besturk/claude-todo/makerworld-thermoform/healy-cerceve/healy-c-erkek.stl

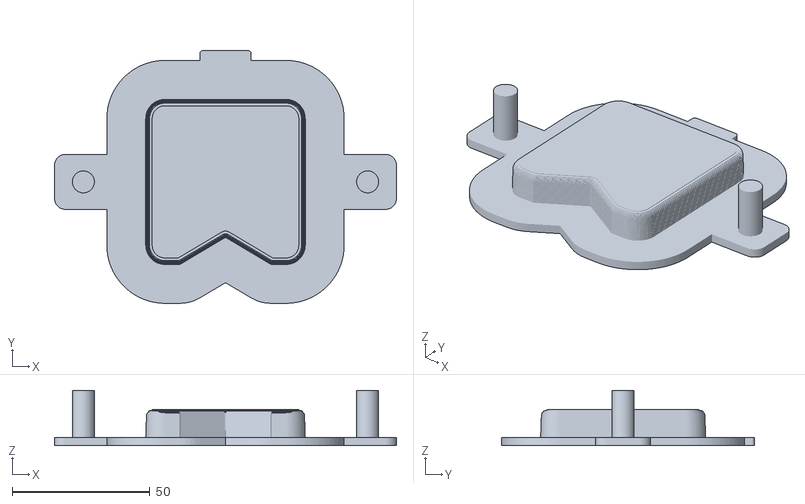
[picture p1: CAD file, 2026-10-13]
makerworld-thermoform/healy-cerceve/healy-c-erkek.stl
124.3 x 91.8 x 20.0
