besturk/claude-todo/makerworld-thermoform/healy-formify/TF-Healy-F-kalip-PETG.3mf

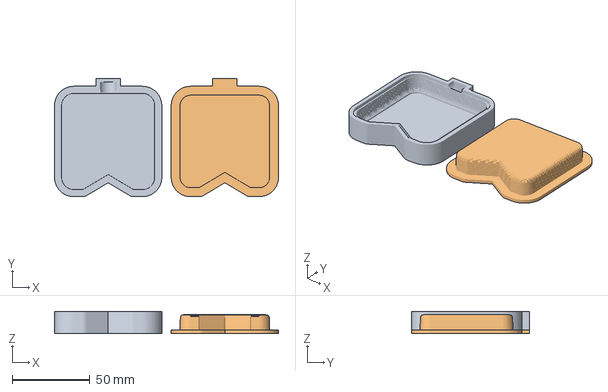
[picture p2: CAD file, 2026-10-12]
makerworld-thermoform/healy-formify/TF-Healy-F-kalip-PETG.3mf
144.0 x 76.1 x 14.2 mm
disi-kalip
erkek-kalip
