besturk/claude-todo/makerworld-thermoform/healy-hk/TF-Healy-HK-levha-PLA.3mf

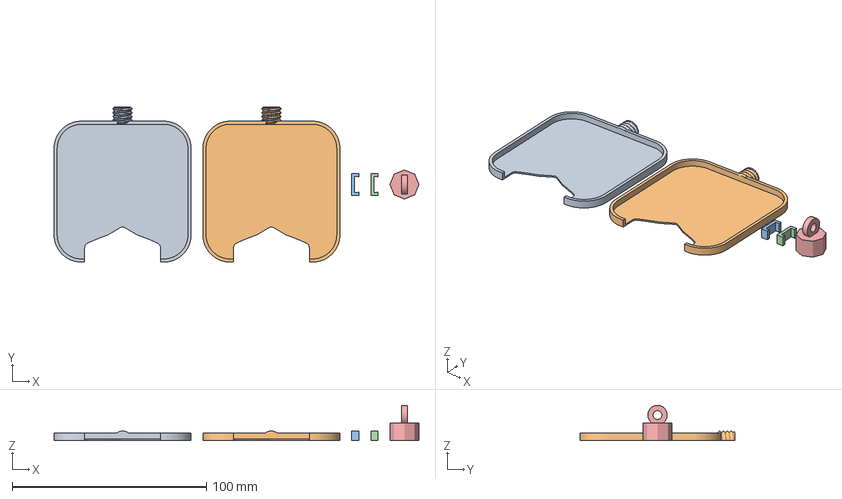
[picture p3: CAD file, 2026-10-14]
makerworld-thermoform/healy-hk/TF-Healy-HK-levha-PLA.3mf
188.0 x 80.0 x 18.2 mm
levha-1
levha-2
kiskac-1
kiskac-2
askili-somun
