besturk/claude-todo/makerworld-thermoform/healy-kalip/healy-levha.stl

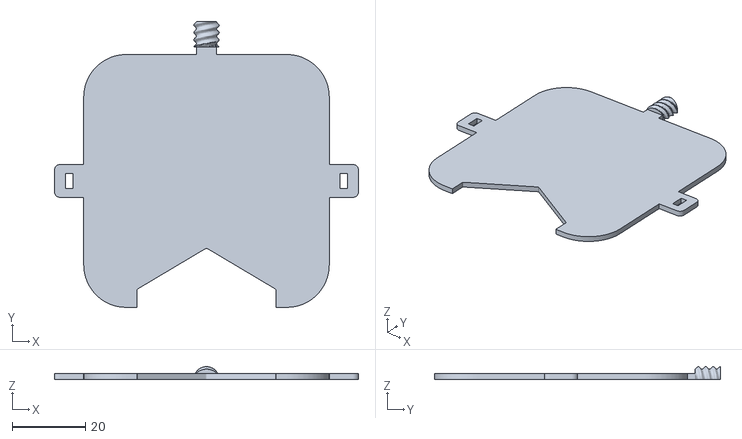
[picture p4: CAD file, 2026-10-12]
makerworld-thermoform/healy-kalip/healy-levha.stl
83.2 x 78.2 x 3.50
