besturk/claude-todo/makerworld-thermoform/kare-50/kare50-zipka.stl

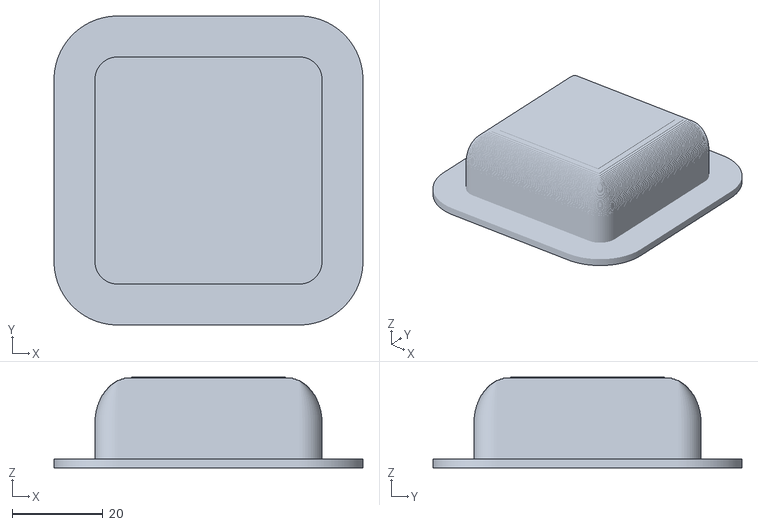
[picture p5: CAD file, 2026-10-11]
makerworld-thermoform/kare-50/kare50-zipka.stl
68.0 x 68.0 x 20.0
