besturk/claude-todo/makerworld-thermoform/healy-cerceve/healy-c-levha_duz.stl

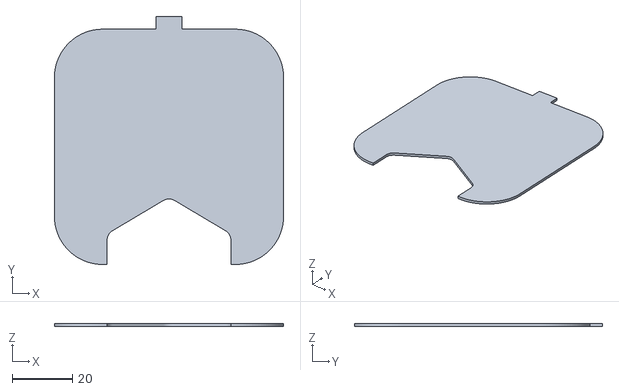
[picture p6: CAD file, 2026-10-13]
makerworld-thermoform/healy-cerceve/healy-c-levha_duz.stl
76.0 x 82.2 x 1.00
