besturk/claude-todo/makerworld-thermoform/healy-formify/TF-Healy-F-levhalar-PLA.3mf

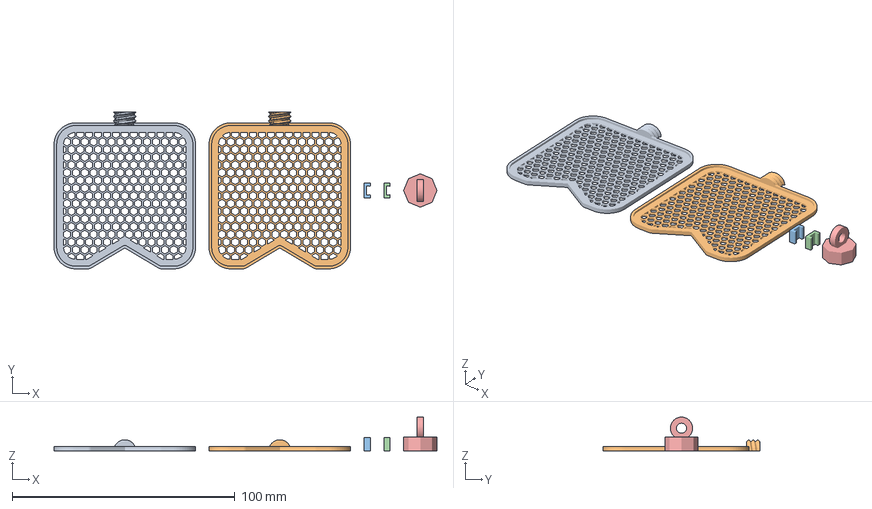
[picture p7: CAD file, 2026-10-12]
makerworld-thermoform/healy-formify/TF-Healy-F-levhalar-PLA.3mf
172.0 x 70.4 x 15.2 mm
levha-1
levha-2
kiskac-1
kiskac-2
somun
