besturk/claude-todo/makerworld-thermoform/healy-hk/healy-hk-disi.stl

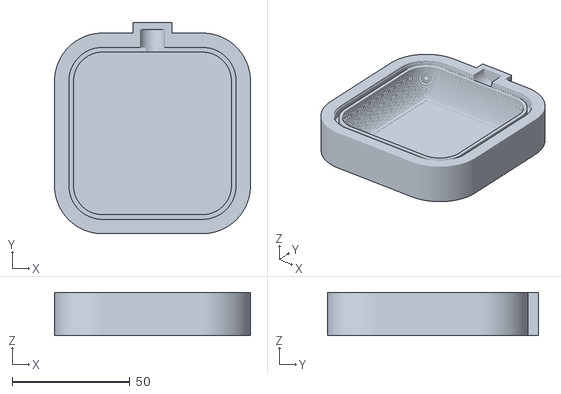
[picture p8: CAD file, 2026-10-14]
makerworld-thermoform/healy-hk/healy-hk-disi.stl
83.2 x 89.8 x 18.3
