besturk/claude-todo/makerworld-thermoform/healy-kalip/healy-zipka.stl

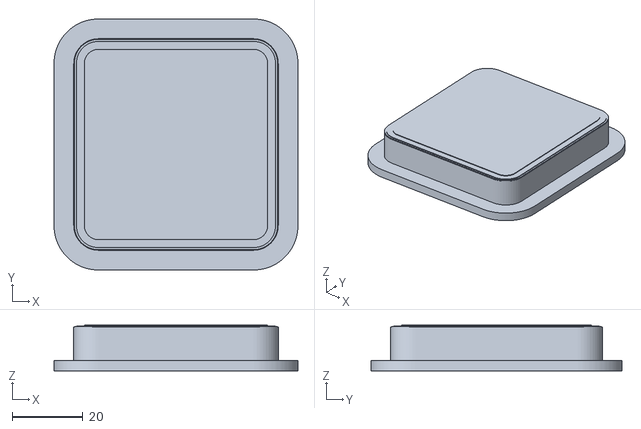
[picture p9: CAD file, 2026-10-12]
makerworld-thermoform/healy-kalip/healy-zipka.stl
69.2 x 71.2 x 13.0
