besturk/claude-todo/makerworld-thermoform/kare-50/kare50-kalip.stl

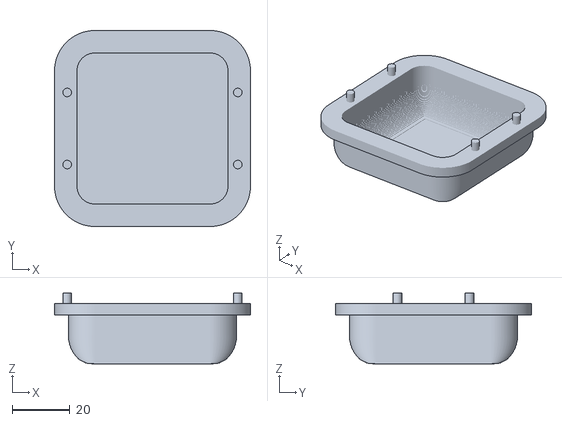
[picture p10: CAD file, 2026-10-11]
makerworld-thermoform/kare-50/kare50-kalip.stl
68.0 x 68.0 x 24.6
