besturk/claude-todo/makerworld-thermoform/healy-cerceve/healy-c-direk_destek.stl

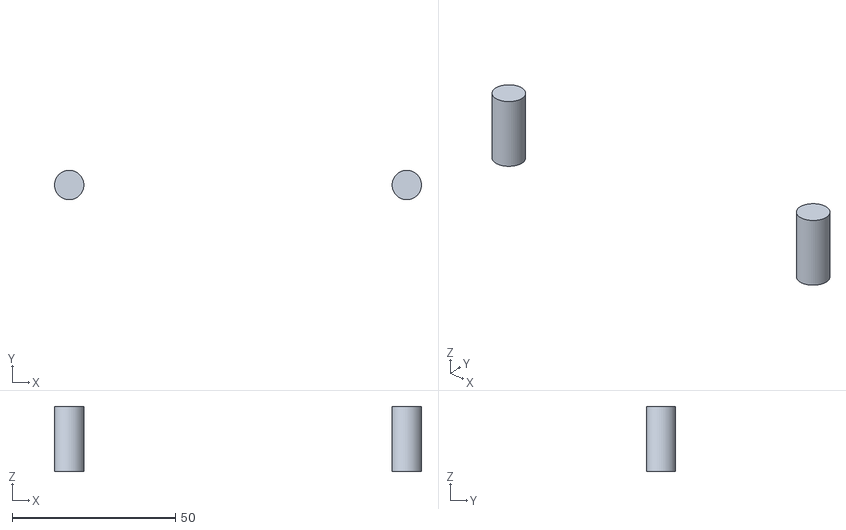
[picture p11: CAD file, 2026-10-13]
makerworld-thermoform/healy-cerceve/healy-c-direk_destek.stl
112.3 x 9.00 x 20.0
