besturk/claude-todo/makerworld-thermoform/healy-formify/healy-f-levha.stl

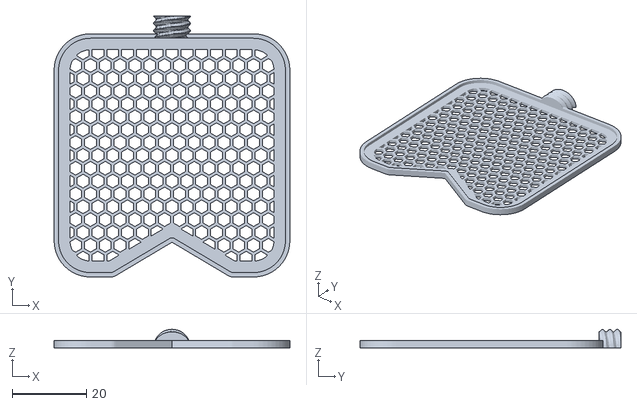
[picture p12: CAD file, 2026-10-12]
makerworld-thermoform/healy-formify/healy-f-levha.stl
63.6 x 70.4 x 5.00
