besturk/claude-todo/makerworld-thermoform/healy-hk/healy-hk-levha_govde.stl

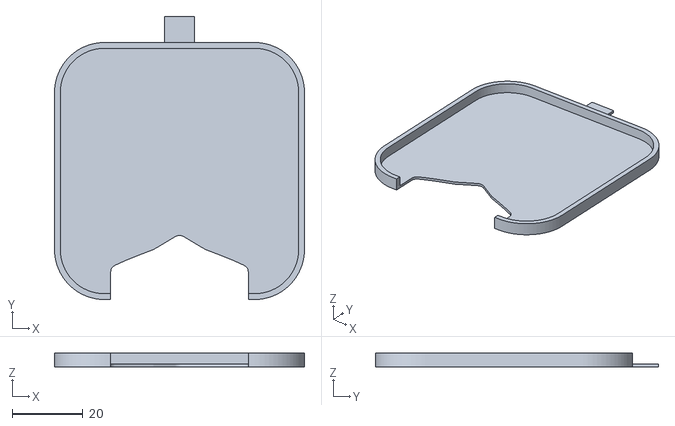
[picture p13: CAD file, 2026-10-14]
makerworld-thermoform/healy-hk/healy-hk-levha_govde.stl
70.7 x 80.0 x 4.00
