besturk/claude-todo/makerworld-thermoform/healy-kalip/healy-kalip.stl

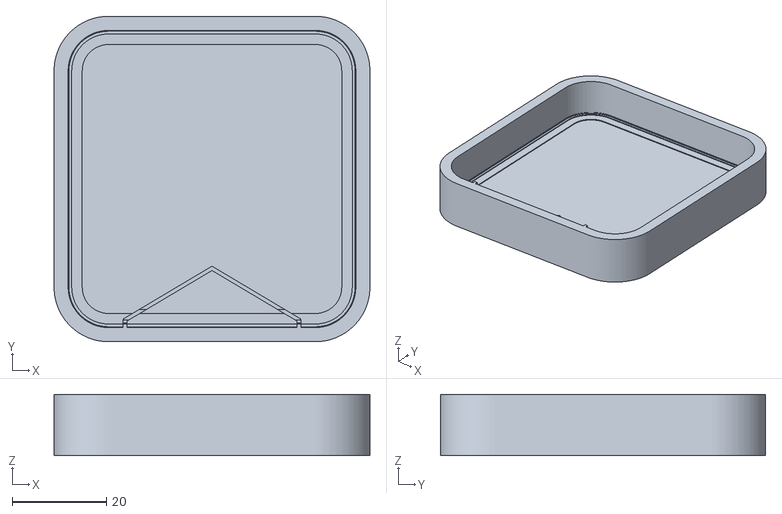
[picture p14: CAD file, 2026-10-12]
makerworld-thermoform/healy-kalip/healy-kalip.stl
67.2 x 69.2 x 13.0
