besturk/claude-todo/makerworld-thermoform/healy-cerceve/TF-Healy-cerceve-kalip-PETG.3mf

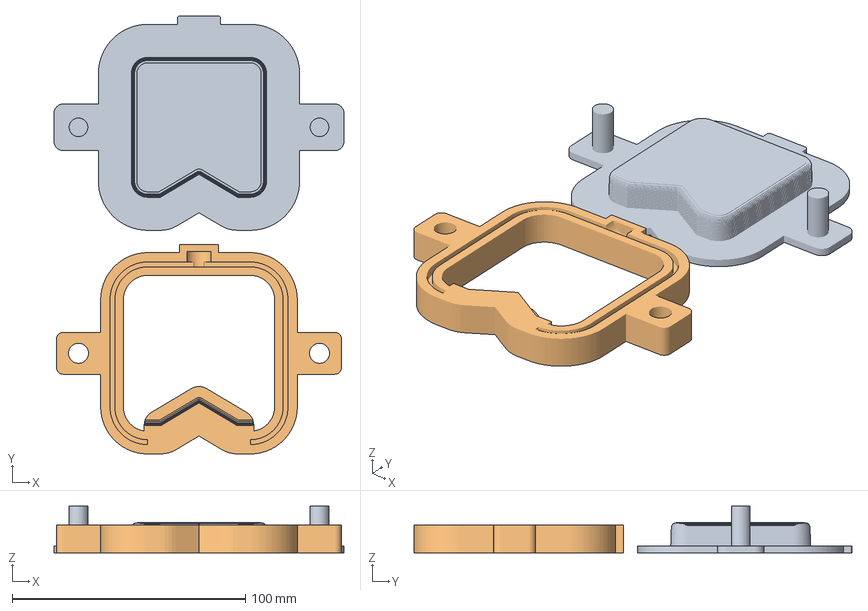
[picture p15: CAD file, 2026-10-13]
makerworld-thermoform/healy-cerceve/TF-Healy-cerceve-kalip-PETG.3mf
124.3 x 187.7 x 20.0 mm
erkek-kalip
cerceve
