besturk/claude-todo/makerworld-thermoform/healy-formify/healy-f-disi.stl

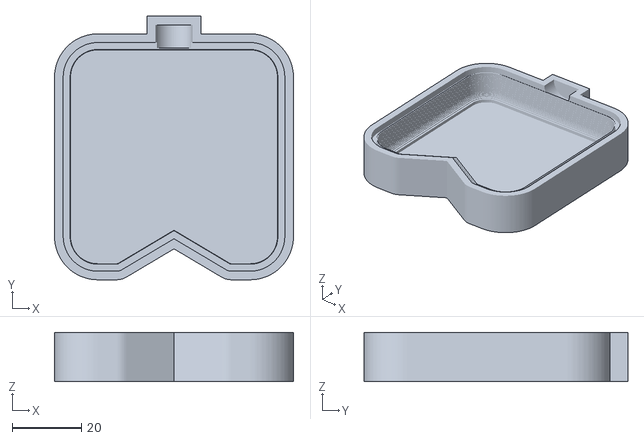
[picture p16: CAD file, 2026-10-12]
makerworld-thermoform/healy-formify/healy-f-disi.stl
69.0 x 76.1 x 14.2
