besturk/claude-todo/makerworld-thermoform/healy-hk/healy-hk-erkek.stl

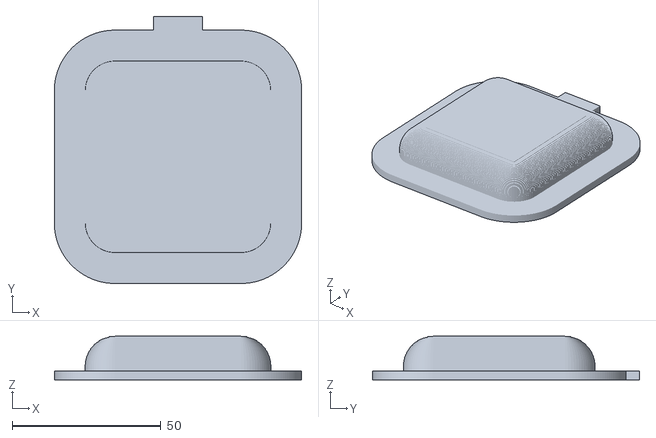
[picture p17: CAD file, 2026-10-14]
makerworld-thermoform/healy-hk/healy-hk-erkek.stl
83.2 x 89.8 x 14.7
