besturk/claude-todo/makerworld-thermoform/healy-kalip/TF-Healy-levhalar-PLA.3mf

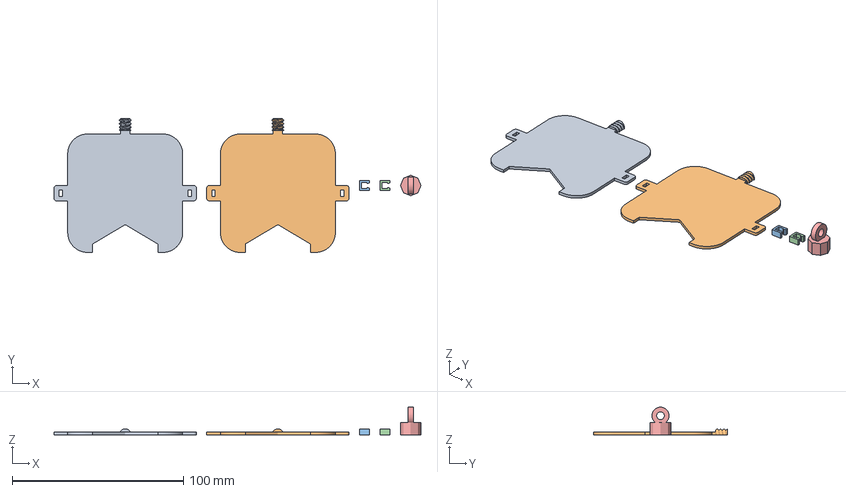
[picture p18: CAD file, 2026-10-12]
makerworld-thermoform/healy-kalip/TF-Healy-levhalar-PLA.3mf
214.4 x 78.2 x 16.2 mm
levha-1
levha-2
c-kiskac-1
c-kiskac-2
askili-somun
