besturk/claude-todo/makerworld-thermoform/healy-cerceve/healy-c-cerceve_baski.stl

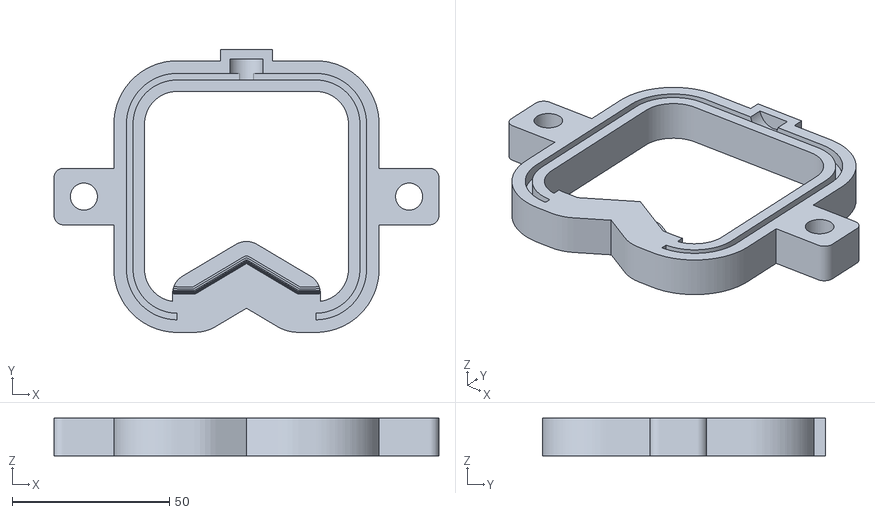
[picture p19: CAD file, 2026-10-13]
makerworld-thermoform/healy-cerceve/healy-c-cerceve_baski.stl
122.3 x 89.8 x 12.0
