besturk/claude-todo/makerworld-thermoform/healy-formify/healy-f-erkek.stl

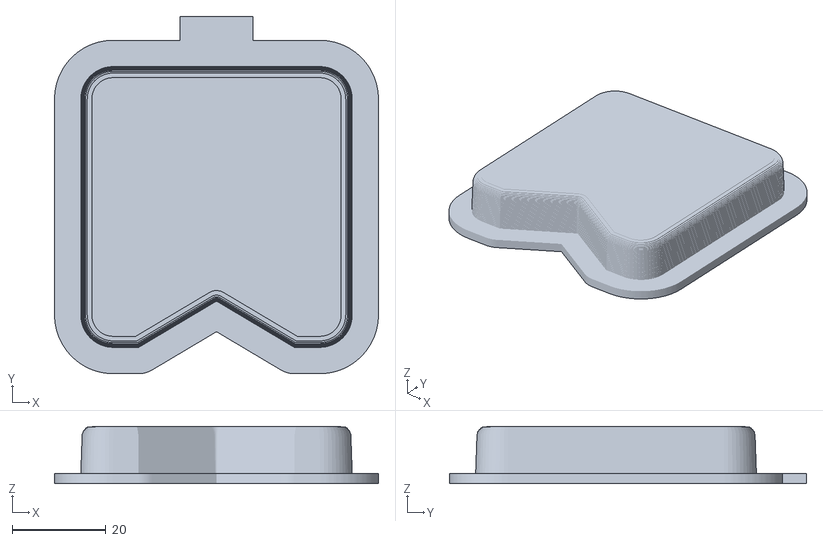
[picture p20: CAD file, 2026-10-12]
makerworld-thermoform/healy-formify/healy-f-erkek.stl
69.0 x 76.1 x 12.2
