besturk/claude-todo/makerworld-thermoform/healy-hk/healy-hk-kiskac.stl

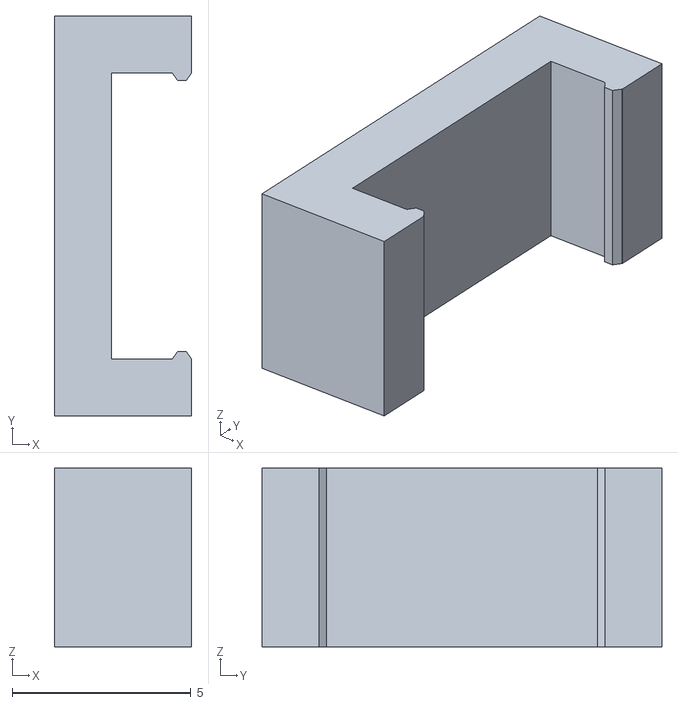
[picture p21: CAD file, 2026-10-14]
makerworld-thermoform/healy-hk/healy-hk-kiskac.stl
3.85 x 11.2 x 5.00
