besturk/claude-todo/makerworld-thermoform/healy-kalip/TF-Healy-kalip-PETG.3mf

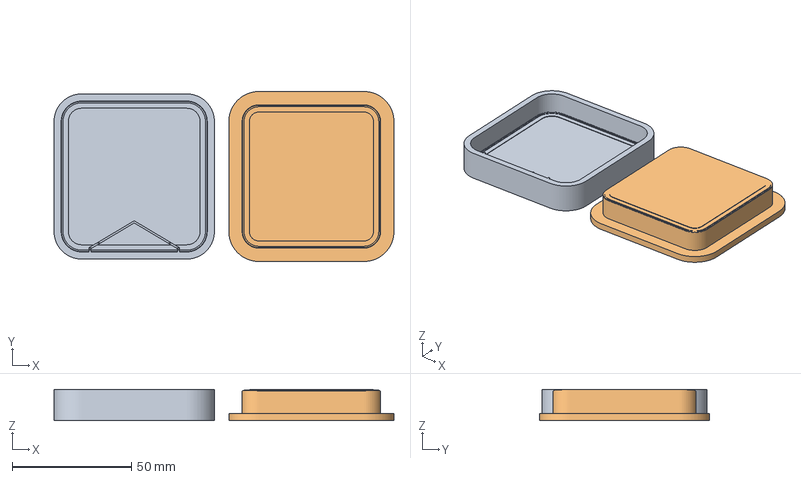
[picture p22: CAD file, 2026-10-12]
makerworld-thermoform/healy-kalip/TF-Healy-kalip-PETG.3mf
142.4 x 71.2 x 13.0 mm
healy-kalip-disi
healy-zipka-erkek
