besturk/claude-todo/makerworld-thermoform/healy-cerceve/healy-c-bant.stl

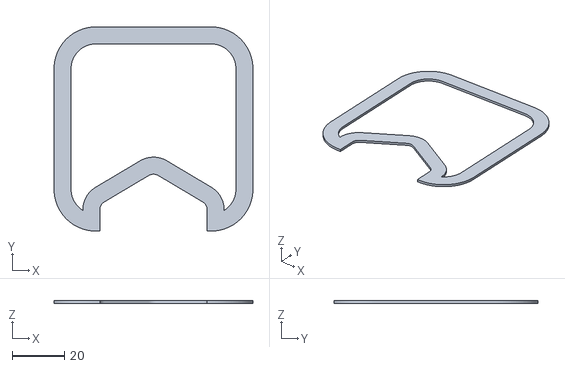
[picture p23: CAD file, 2026-10-13]
makerworld-thermoform/healy-cerceve/healy-c-bant.stl
76.0 x 78.0 x 1.00
