besturk/claude-todo/makerworld-thermoform/healy-formify/healy-f-somun.stl

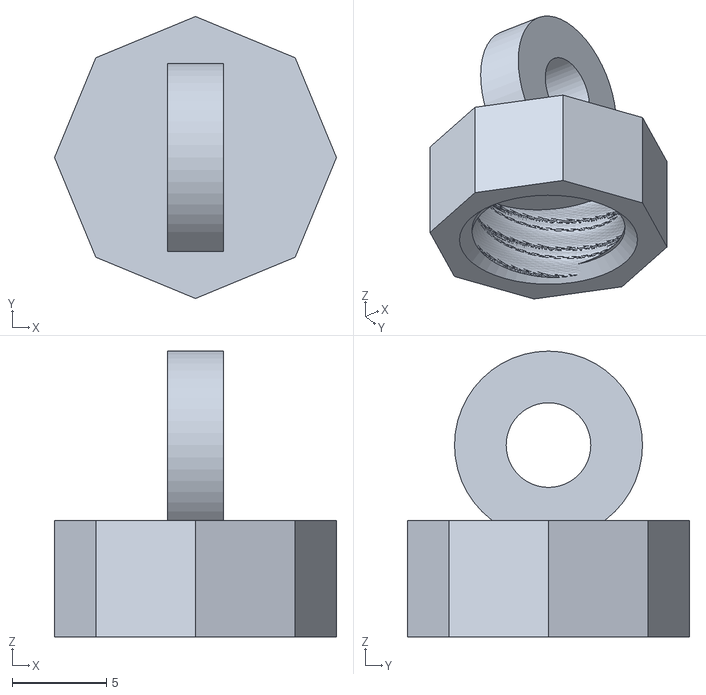
[picture p24: CAD file, 2026-10-12]
makerworld-thermoform/healy-formify/healy-f-somun.stl
15.0 x 15.0 x 15.2
