besturk/claude-todo/makerworld-thermoform/healy-hk/healy-hk-vida.stl

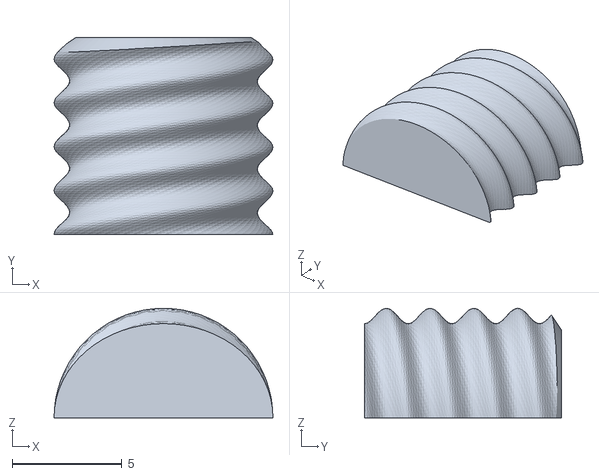
[picture p25: CAD file, 2026-10-14]
makerworld-thermoform/healy-hk/healy-hk-vida.stl
10.0 x 9.00 x 5.00
