besturk/claude-todo/makerworld-thermoform/healy-kalip/healy-levhalar-PLA.3mf

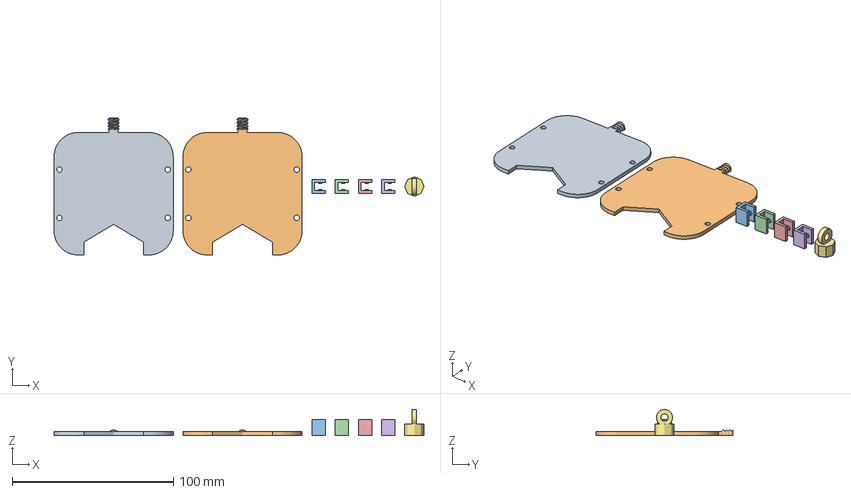
[picture p26: CAD file, 2026-10-11]
makerworld-thermoform/healy-kalip/healy-levhalar-PLA.3mf
229.6 x 85.0 x 16.2 mm
levha-1
levha-2
c-kiskac-1
c-kiskac-2
c-kiskac-3
c-kiskac-4
askili-somun
