besturk/claude-todo/makerworld-thermoform/healy-cerceve/healy-c-levha.stl

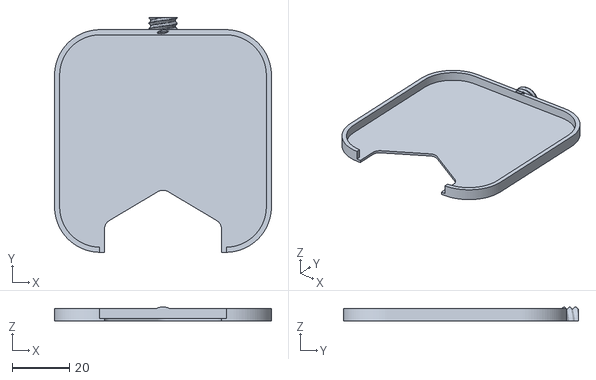
[picture p27: CAD file, 2026-10-13]
makerworld-thermoform/healy-cerceve/healy-c-levha.stl
76.0 x 82.2 x 5.00
