besturk/claude-todo/makerworld-thermoform/healy-formify/healy-f-kiskac.stl

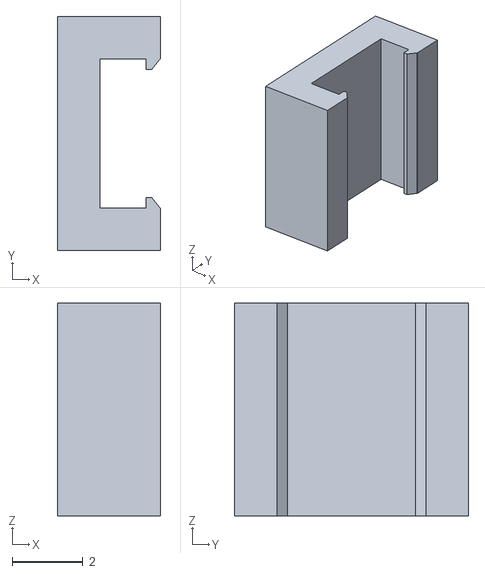
[picture p28: CAD file, 2026-10-12]
makerworld-thermoform/healy-formify/healy-f-kiskac.stl
2.90 x 6.60 x 6.00
