besturk/claude-todo/makerworld-thermoform/healy-hk/healy-hk-somun.stl

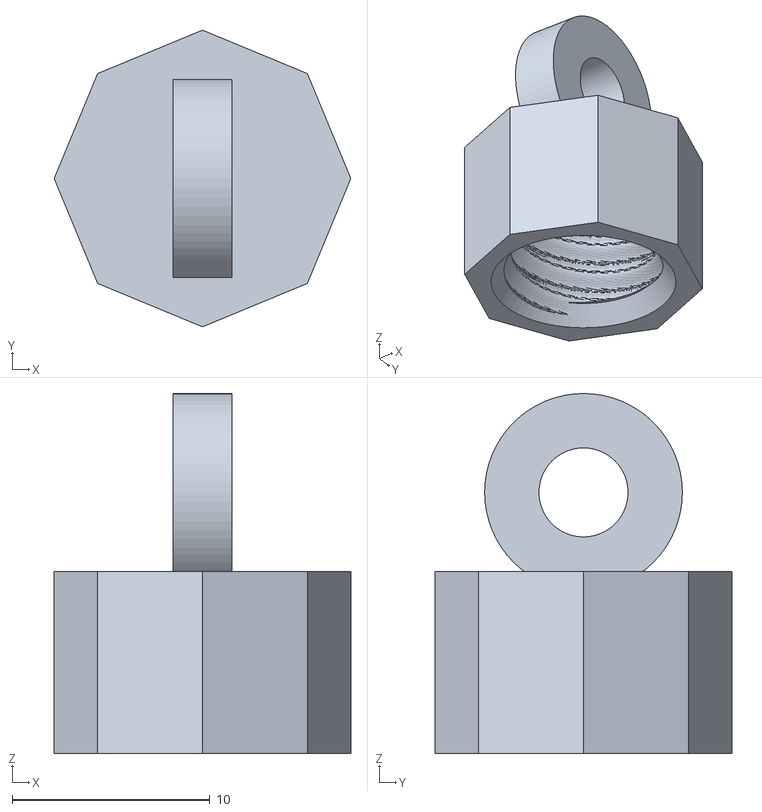
[picture p29: CAD file, 2026-10-14]
makerworld-thermoform/healy-hk/healy-hk-somun.stl
15.0 x 15.0 x 18.2
