besturk/claude-todo/makerworld-thermoform/healy-kalip/healy-kiskac-somun.stl

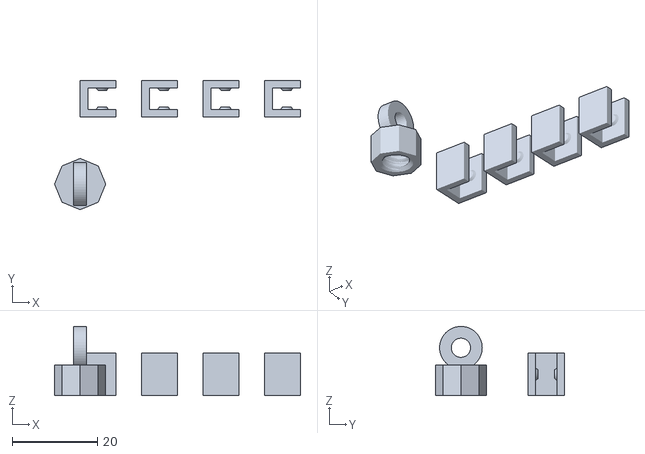
[picture p30: CAD file, 2026-10-11]
makerworld-thermoform/healy-kalip/healy-kiskac-somun.stl
57.6 x 30.3 x 16.2
