besturk/claude-todo/makerworld-thermoform/healy-cerceve/TF-Healy-cerceve-levha-PLA.3mf

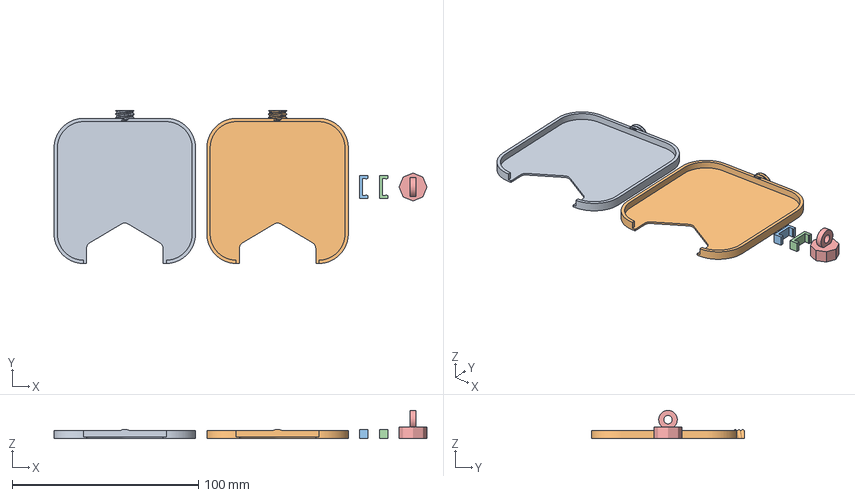
[picture p31: CAD file, 2026-10-13]
makerworld-thermoform/healy-cerceve/TF-Healy-cerceve-levha-PLA.3mf
200.2 x 82.2 x 15.2 mm
levha-1
levha-2
yan-kiskac-1
yan-kiskac-2
askili-somun
