besturk/claude-todo/makerworld-thermoform/healy-hk/TF-Healy-HK-kalip-PETG.3mf

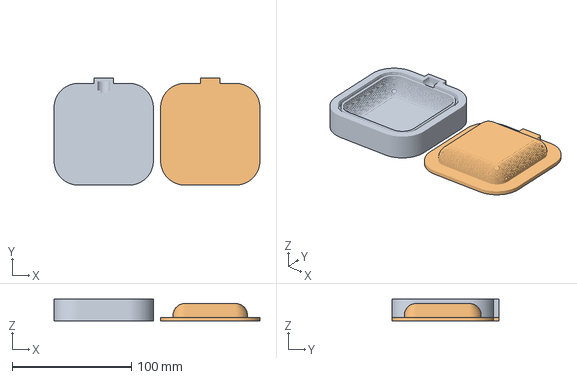
[picture p32: CAD file, 2026-10-14]
makerworld-thermoform/healy-hk/TF-Healy-HK-kalip-PETG.3mf
172.4 x 89.8 x 18.3 mm
disi-kalip
erkek-kalip
