besturk/claude-todo/makerworld-thermoform/healy-cerceve/healy-c-kaburga.stl

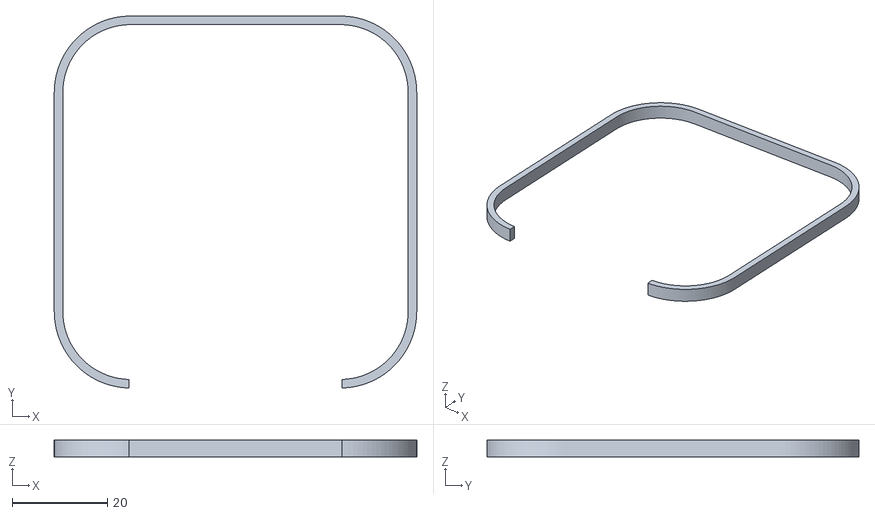
[picture p33: CAD file, 2026-10-13]
makerworld-thermoform/healy-cerceve/healy-c-kaburga.stl
76.0 x 78.0 x 3.51
