besturk/claude-todo/makerworld-thermoform/healy-cerceve/healy-c-vida.stl

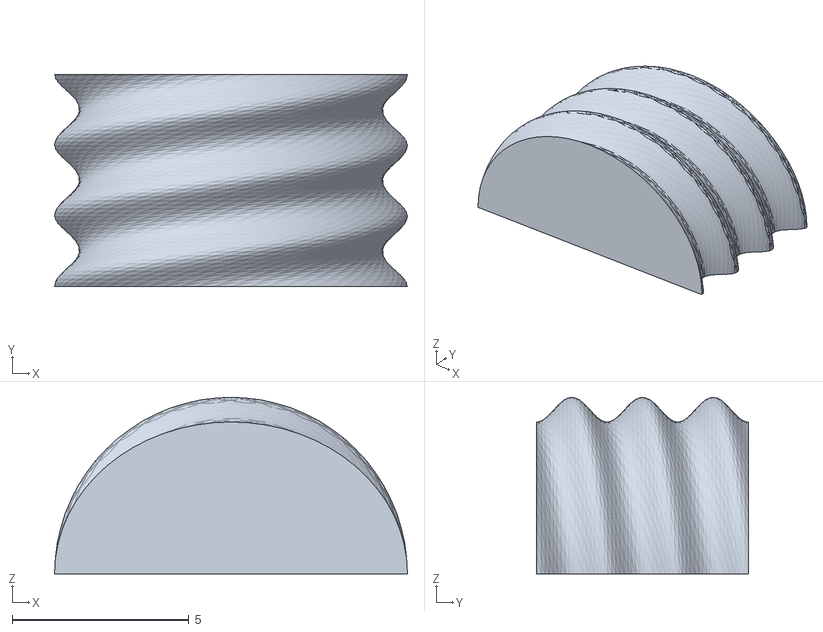
[picture p34: CAD file, 2026-10-12]
makerworld-thermoform/healy-cerceve/healy-c-vida.stl
10.0 x 6.00 x 5.00
