besturk/claude-todo/makerworld-thermoform/healy-cerceve/healy-c-kiskac.stl

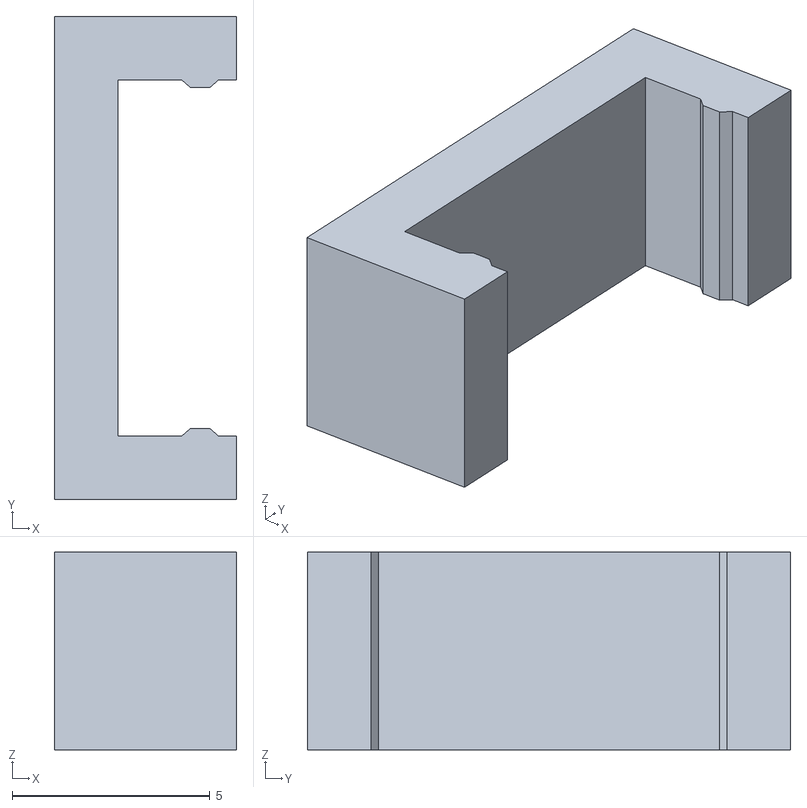
[picture p35: CAD file, 2026-10-12]
makerworld-thermoform/healy-cerceve/healy-c-kiskac.stl
4.60 x 12.2 x 5.00
