besturk/claude-todo/makerworld-thermoform/healy-hk-vkes.scad

// healy-hk-vkes.py ile üretildi — elle değiştirme
// esneme katsayısı s = 1.578
VKES_PTS = [[-19.499, -28.775], [-19.337, -27.837], [-19.174, -27.501], [-19.012, -27.267], [-18.849, -27.090], [-18.687, -26.947], [-18.524, -26.830], [-18.362, -26.734], [-18.199, -26.649], [-18.037, -26.570], [-17.874, -26.491], [-17.712, -26.412], [-17.549, -26.335], [-17.387, -26.258], [-17.224, -26.182], [-17.062, -26.107], [-16.899, -26.032], [-16.737, -25.958], [-16.574, -25.885], [-16.412, -25.812], [-16.249, -25.739], [-16.087, -25.667], [-15.924, -25.596], [-15.762, -25.525], [-15.599, -25.454], [-15.437, -25.384], [-15.274, -25.314], [-15.112, -25.245], [-14.949, -25.176], [-14.787, -25.108], [-14.624, -25.040], [-14.462, -24.972], [-14.299, -24.905], [-14.137, -24.837], [-13.974, -24.771], [-13.812, -24.704], [-13.649, -24.638], [-13.487, -24.572], [-13.324, -24.506], [-13.162, -24.441], [-12.999, -24.376], [-12.837, -24.311], [-12.674, -24.246], [-12.512, -24.182], [-12.349, -24.117], [-12.187, -24.053], [-12.024, -23.990], [-11.862, -23.926], [-11.699, -23.862], [-11.537, -23.799], [-11.374, -23.736], [-11.212, -23.673], [-11.049, -23.610], [-10.887, -23.547], [-10.724, -23.485], [-10.562, -23.422], [-10.399, -23.360], [-10.237, -23.298], [-10.074, -23.236], [-9.912, -23.174], [-9.749, -23.112], [-9.587, -23.050], [-9.425, -22.988], [-9.262, -22.926], [-9.100, -22.865], [-8.937, -22.803], [-8.775, -22.742], [-8.612, -22.680], [-8.450, -22.619], [-8.287, -22.558], [-8.125, -22.496], [-7.962, -22.435], [-7.800, -22.374], [-7.637, -22.313], [-7.475, -22.251], [-7.312, -22.184], [-7.150, -22.088], [-6.987, -21.991], [-6.825, -21.894], [-6.662, -21.798], [-6.500, -21.701], [-6.337, -21.605], [-6.175, -21.508], [-6.012, -21.411], [-5.850, -21.315], [-5.687, -21.218], [-5.525, -21.122], [-5.362, -21.025], [-5.200, -20.928], [-5.037, -20.832], [-4.875, -20.735], [-4.712, -20.638], [-4.550, -20.542], [-4.387, -20.445], [-4.225, -20.349], [-4.062, -20.252], [-3.900, -20.155], [-3.737, -20.059], [-3.575, -19.962], [-3.412, -19.866], [-3.250, -19.769], [-3.087, -19.672], [-2.925, -19.576], [-2.762, -19.479], [-2.600, -19.382], [-2.437, -19.286], [-2.275, -19.189], [-2.112, -19.093], [-1.950, -18.996], [-1.787, -18.899], [-1.625, -18.803], [-1.462, -18.706], [-1.300, -18.610], [-1.137, -18.521], [-0.975, -18.445], [-0.812, -18.382], [-0.650, -18.332], [-0.487, -18.295], [-0.325, -18.267], [-0.162, -18.251], [0.000, -18.247], [0.162, -18.251], [0.325, -18.267], [0.487, -18.295], [0.650, -18.332], [0.812, -18.382], [0.975, -18.445], [1.137, -18.521], [1.300, -18.610], [1.462, -18.706], [1.625, -18.803], [1.787, -18.899], [1.950, -18.996], [2.112, -19.093], [2.275, -19.189], [2.437, -19.286], [2.600, -19.382], [2.762, -19.479], [2.925, -19.576], [3.087, -19.672], [3.250, -19.769], [3.412, -19.866], [3.575, -19.962], [3.737, -20.059], [3.900, -20.155], [4.062, -20.252], [4.225, -20.349], [4.387, -20.445], [4.550, -20.542], [4.712, -20.638], [4.875, -20.735], [5.037, -20.832], [5.200, -20.928], [5.362, -21.025], [5.525, -21.122], [5.687, -21.218], [5.850, -21.315], [6.012, -21.411], [6.175, -21.508], [6.337, -21.605], [6.500, -21.701], [6.662, -21.798], [6.825, -21.894], [6.987, -21.991], [7.150, -22.088], [7.312, -22.184], [7.475, -22.251], [7.637, -22.313], [7.800, -22.374], [7.962, -22.435], [8.125, -22.496], [8.287, -22.558], [8.450, -22.619], [8.612, -22.680], [8.775, -22.742], [8.937, -22.803], [9.100, -22.865], [9.262, -22.926], [9.425, -22.988], [9.587, -23.050], [9.749, -23.112], [9.912, -23.174], [10.074, -23.236], [10.237, -23.298], [10.399, -23.360], [10.562, -23.422], [10.724, -23.485], [10.887, -23.547], [11.049, -23.610], [11.212, -23.673], [11.374, -23.736], [11.537, -23.799], [11.699, -23.862], [11.862, -23.926], [12.024, -23.990], [12.187, -24.053], [12.349, -24.117], [12.512, -24.182], [12.674, -24.246], [12.837, -24.311], [12.999, -24.376], [13.162, -24.441], [13.324, -24.506], [13.487, -24.572], [13.649, -24.638], [13.812, -24.704], [13.974, -24.771], [14.137, -24.837], [14.299, -24.905], [14.462, -24.972], [14.624, -25.040], [14.787, -25.108], [14.949, -25.176], [15.112, -25.245], [15.274, -25.314], [15.437, -25.384], [15.599, -25.454], [15.762, -25.525], [15.924, -25.596], [16.087, -25.667], [16.249, -25.739], [16.412, -25.812], [16.574, -25.885], [16.737, -25.958], [16.899, -26.032], [17.062, -26.107], [17.224, -26.182], [17.387, -26.258], [17.549, -26.335], [17.712, -26.412], [17.874, -26.491], [18.037, -26.570], [18.199, -26.649], [18.362, -26.734], [18.524, -26.830], [18.687, -26.947], [18.849, -27.090], [19.012, -27.267], [19.174, -27.501], [19.337, -27.837], [19.499, -28.775], [19.499, -70.000], [-19.499, -70.000]];
