besturk/claude-todo/makerworld-thermoform/kiskac-secenekleri.html

# Kenar deliğinden geçen kıskaç — 3 seçenek

Gri: üst üste gelen iki levha kenarı (4 mm + 4 mm). Kesitler deliğin ortasından. Görseller ayrı ayrı ölçeklendi; boyutları birbirine göre kıyaslamayın.

## 1 · Çıtçıt düğme

Kesit · açık

Kesit · kapalı

Parça

- Erkek parça alttan deliğe girer, uçtaki bilye üstteki başlığa ‘çıt’ diye oturur.
- Açmak: başlığı tırnakla çekip çıkarmak. Kapatmak: bastırmak.
- Her delik için 2 parça; küçük oldukları için kaybolabilir.

## 2 · Tutamaklı geçme pim

Kesit · açık

Kesit · kapalı

Parça

- Hafif konik, yivli pim iki deliğe sıkıca itilir; sürtünmeyle durur.
- Açmak: alttaki halkadan çekmek. Kapatmak: itmek.
- Tek parça; halka parmakla rahat tutulur. Sık açılıp kapanırsa yivler zamanla gevşeyebilir.

## 3 · Mıknatıs

Kesit · açık

Kesit · kapalı

Parça

- Her iki kabuğun deliğine 6×2 mm neodim mıknatıs yapıştırılır (karşılıklı ters kutup).
- Açmak: kabukları ayırmak. Kapatmak: yaklaştırmak — en kolayı.
- Ayrıca basılan parça yok; mıknatıs satın alınır. Delik ve kalıp pimi 6 mm olur.
- Tutuş gücü diğerlerinden zayıf; ağır içerik için yetmeyebilir.
