besturk/claude-todo/makerworld-thermoform/levha-sabitleme-secenekleri.html

# Levhayı pimle sabitleme — 2 seçenek

Kalp, 100 mm. Kaba prototip; pim sayısı ve yerleri son hâl değil.

## (a) Delik levhanın kenarında

Basılacak levha, üstten

Patlak görünüş — mavi kalıp + pimler, beyaz levha, turuncu zıpka

Kesit, pimlerden geçen hat — levha pimlere takılı, zıpka inmek üzere

- Levha kenarı 4 → 7 mm genişler; delikler bu kenarda.
- Kalıp flanşında 4 mm boyunda pimler; levhanın üst yüzüyle aynı hizada biter.
- Zıpka flanşı üstten levhaya bastırır, pimlere çarpmaz — zıpka değişmez.
- Delikler ürünün birleşme kenarında kalır, bir kısmı görünür.

## (b) Delik kesilip atılan kulakta

Basılacak levha, üstten

Patlak görünüş — mavi kalıp + pimler, beyaz levha, turuncu zıpka

Kesit, pimlerden geçen hat — levha pimlere takılı, zıpka inmek üzere

- Levha kenarı 4 mm kalır; delikler dışarı taşan kulaklarda.
- Kalıp flanşı kulakların altında genişler, pimler orada.
- Şekil verdikten sonra kulaklar kırmızı kesik çizgiden kesilir; üründe delik kalmaz.
- Her üründe 4 kesim işi.
