besturk/claude-todo/makerworld-thermoform/healy-hk/healy-hk.html

# Healy kılıfı — Hello Kitty yöntemi, tam set

## Kesit: V ve vida

## Basma sırası

## Kapalı kılıf

## Parçalar

Dişi kalıp (PETG) | Yastık boşluk (R10,8), 1 mm levha cebi, kaburga oluğu, uzantı dilinde ucu kapalı yarım vida yatağı. 0,28 mm katman, %10 dolgu. | 83,2 × 89,8 × 18,3 mm
Erkek kalıp (PETG) | 3 mm taban (vidanın üstünü de örter) + yastık çıkıntı (R10, 11,5 mm). | 83,2 × 89,8 × 14,7 mm
Levha ×2 (PLA) | 0,8 mm, %25 honeycomb, kabuk 0; 1,65 × 4 mm kaburga; V önceden kesik; yarım vida Ø10 × 9 mm, ucu pahlı, dolu basılır. | 70,7 × 80 mm
Kıskaç ×2 (PLA) | İki kaburgayı (2 × 4 mm) yandan kavrar, uçta tırnak. | 3,8 × 11,2 × 5 mm
Askılı somun (PLA) | 8 mm diş, girişi pahlı; 4 duvar, %40, 5 mm brim. | 15 × 15 × 18,2 mm

## Denetimler

Healy (kenarı r2,5 ya da r3,5, V çentikli) | sığıyor (0 mm³ dışarıda)
Kalıplar arası boşluk | 0,8 mm
Levha cepte (vida dahil) | çakışma 0; 0,3 mm kayarsa çarpar (28–49 mm³) → kayamaz
Kabuk ↔ dişi / erkek | çakışma 0 / 0
Vida yatağı | dişlerle yatak arası 0,3 mm; erkek tabanı vidanın düz yüzünün 0,2 mm üstünde; yatak vida ucundan 3,5 mm öteye kadar
V | kapalı kılıfta cihazın çentiğinde (+0,5 mm) kabuk malzemesi 0 mm³ → girişler açık
Somun | iki kabuğun birleşik vidasına oturuyor
Kıskaçlar | iki kaburgaya oturuyor, kabuklarla çakışma 0
3MF | bütün parçalar su geçirmez, tablaya oturuyor; PLA denetimi 0 hata

Hesaba dayanan kısım: V'nin levhada nereden kesileceği, levhanın kalıbın düz tepesinde esnemediği ve kenarda eşit esnediği varsayımıyla hesaplandı (esneme 1,58). V kenarı kalıpta kaburgayla değil iki kalıbın arasında sıkışarak tutuluyor. Açıklığın kenarı birkaç mm oynayabilir; ilk basmada bakılacak yer burası.
