besturk/claude-todo/makerworld-thermoform/hello-kitty-inceleme/hello-kitty-inceleme.html

# Hello Kitty thermoform seti — inceleme

Dört dosya geometri olarak aynı. Fark yalnızca desen (honeycomb / gyroid) ve AMS sürümündeki renk değiştirici parçalar. Yazıcı profili A1 mini.

## 1. Kalıp: dişi + erkek, arada 0,8 mm

## 2. Levha kenarı

Solda düz kenar: 0,8 mm levha ve en dışta 1,65 × 4 mm kaburga.

## 3. Birleştirme parçaları

## 4. Hello Kitty ve bizim Healy kalıbı

| Hello Kitty | Healy (son basılan, çerçeve yöntemi)
Yöntem | Dişi kalıp (alt) + erkek kalıp (üst). Erkeğin taban plakası dişinin üstüne oturur, aradaki boşluk tam levha kalınlığı (0,8 mm, ölçüldü: ortanca 0,82). | Erkek kalıp + oluklu çerçeve; dişi kalıp yok. Kabuğun dış yüzünü hiçbir şey şekillendirmiyor.
Kalıbın şekli | Yastık: düz yüz + ~10 mm yarıçaplı yuvarlak kenar, 15 mm derin. Esneme kenara yayılıyor. | Kutu: dik duvar + 2 mm kenar yuvarlaması, 10 mm. Esneme dar bir halkada toplanıyor.
Levha | 0,8 mm | 1,0 mm
Kilit kaburgası | En dış kenarda 1,65 mm geniş, 4 mm yüksek (levhanın 3,2 mm üstü) | 1,8 × 3,5 mm
Kaburga nereye oturuyor | Dişi kalıbın ağzında, boşluğun 1,5 mm dışındaki 2 × ~5 mm oluğa. Levha boşluktan sadece ~3,5 mm taşıyor. | Çerçevenin altındaki oluğa; levha şekilden 9 mm taşıyor
Desen | %25 honeycomb veya gyroid (iki ayrı dosya), alt/üst kabuk 0, 2 duvar, 0,2 mm katman | Aynı: %25 honeycomb, kabuk 0
Renkli detaylar | Göz, burun, fiyonk, çizgiler levhanın üstüne 0,8 mm'lik ayrı parçalar, %45 dolgu, duvarsız; AMS dosyasında kenar kaburgası siyah (değiştirici parça) | —
Kalıp baskısı | PETG, 0,28 mm katman, %10 dolgu, 4 alt / 5 üst kabuk | PETG, 0,2 mm, %20 / %100
Birleştirme | Bir yanda iki levhanın yarım vidası + askı halkalı tırtıllı somun; öbür yanda küçük U kıskaç | Üstte yarım vida + askılı somun, yanlarda 2 U kıskaç
Her yüz için kalıp | Ön ve arka yüz için ayrı kalıp çifti (R ve L) | Tek kalıp, iki levha aynı

## 5. Healy'ye uygulanırsa: kalıp kesiti seçenekleri

Önerim: Hello Kitty'nin yöntemine geçmek: dişi + erkek kalıp, 0,8 mm levha, kaburga dişinin ağzındaki oluğa, kalıp yastık şeklinde R6 (kılıf her yanda 1 mm, kalınlıkta 1 mm büyür). R6, Hello Kitty'nin R10'u kadar yumuşak değil ama cihazı fazla büyütmüyor; R8 daha yumuşak, kılıf her yanda 1,6 mm büyür. Yarım vida + askılı somun aynı fikir, kalır; V açıklığı ayrıca bu yönteme uyarlanacak.
