besturk/claude-todo/makerworld-thermoform/healy-cerceve/healy-cerceve.html

# Healy kılıfı — çerçeve yöntemi, V açık

## Girişlerin önü (kapalı kılıf, V yüzüne dik kesit)

## V bölgesi

## Basma sırası

## Üstten ve kesitler

## Kapalı kılıf

## Parçalar

Erkek kalıp (PETG) | 3 mm taban + Healy yuvası (58×60, 10 mm) + Ø8 kılavuz direk ×2 (direkler %100) | 124,3 × 91,8 × 20 mm
Oluklu çerçeve (PETG, %100) | 12 mm, üstü düz (ters çevrilip desteksiz basılır); 3,8 mm oluk; V'yi dolduran dudak levhanın V kenarını kalıbın üstüne bastırır | 122,3 × 89,8 × 12 mm
Levha ×2 (PLA) | 1 mm, %25 honeycomb, alt/üst kabuk 0; 6,5 mm dolu bant; 1,8 × 3,5 mm kaburga; V'de cihazın üst yüzünde biter; yarım vida | 76 × 82,2 mm
Yan kıskaç ×2 | iki kaburgayı kavrar | 4,6 × 12,2 × 5 mm
Askılı somun | 4 duvar, %40, 5 mm brim | 15 × 15 × 15,2 mm

## Denetimler

Healy 18,5 mm | sığıyor (18,6'da köşeden 0,08 mm³)
Çentiğin içinde kabuk | 0 mm³ → USB ve soketlerin önü açık
V dudağı | levhaya tam değiyor (ikisi de z = 11,0)
Kabuk ↔ erkek / çerçeve | çakışma 0 / 0
Kabuk 0,3 mm kayarsa | çerçeveye çarpıyor (40–71 mm³) → kayamaz
Çerçeve direklerde 0,35 mm oynarsa | direğe çarpıyor
İki kabuk / kıskaçlar | çakışma 0 / kaburgalara oturuyor
3MF | tüm parçalar su geçirmez, tablada, z = 0'da; PLA denetimi 0 hata

Denenmemiş: V kenarı kaburgayla değil, çerçeve dudağının baskısıyla tutuluyor. Vida ve desen bu sürümde değişmedi.
