besturk/claude-todo/makerworld-thermoform/healy-cerceve/v-karsilastirma.html

# V bölgesi — mevcut ve öneri

| MEVCUT (basılan) | ÖNERİ
Levha V'de nerede bitiyor | Çentiğin dışında, tabanda; çentik duvarlarını sarıyor | Cihazın üst yüzünde, V çizgisinin 3 mm içinde; çentiğe inmiyor
Çentiğin duvarları (USB + soketler) | Kabukla kapalı (çentik içinde 363 mm³ kabuk) | Açık (çentik içinde 0 mm³ kabuk)
V kenarını ne tutuyor | Çerçeve, tabandaki 2 mm şeridi bastırıyor | Çerçevenin V dudağı, kenarı kalıbın üstüne bastırıyor (temas z = 11,0)
Çerçeve | 10 mm düz | V bölgesinde 12 mm; çentiği dolduruyor, kalıbın üstüne 6 mm taşan dudak
Kabuk kayarsa (0,3 mm) | çerçeveye çarpar (49–71 mm³) | çerçeveye çarpar (40–71 mm³)
Çakışma: kabuk / erkek / çerçeve | 0 / 0 | 0 / 0
Kalp setinde denenmiş mi | V kısmı hayır | V kısmı hayır (yeni parça: dudak)

## 1. Kapalı kılıf: girişlerin önü

## 2. Basarken: levha, kalıp ve çerçeve

## 3. Üstten: levha kesimi ve çerçeve

## 4. Çerçeve indirilmiş hali
