besturk/claude-todo/makerworld-thermoform/healy-formify/healy-formify.html

# Healy kalıbı — Formify yapısıyla

## Parçalar

Levha | 0,6 mm, altıgen kafes (adım 4, çubuk 0,8), çerçeve 1,2 mm geniş × 2 mm yüksek, üstte yarım vida Ø10 | 62,8 × 71,3 mm
Dişi kalıp | Levha cebi (0,7 mm) + çerçeve oluğu (V dahil) + şekil boşluğu (kabuk dışı +0,1) | 68,2 × 70,2 × 13,4 mm
Erkek kalıp | Taban plakası dişinin üstüne oturur; çıkıntı = kabuk içi −0,1 | 68,2 × 70,2 × 12,2 mm
U kıskaç ×2 | İki kabuğun çerçevesini yandan kavrar; ucundaki tırnak çerçevenin iç kenarına takılır | 2,9 × 6,6 × 6 mm
Askılı somun | İki yarım vidayı birleştirir, halkadan ip geçer | 15 × 15 × 15,2 mm

## Levha ve dişi kalıp

Levhanın çerçevesi V'nin kenarlarını da dolaşıyor. Dişi kalıptaki oluk da aynı hattı izliyor. Çerçeve oluğa girince levha hiçbir yöne kayamıyor, V kalıpta sabit kalıyor. Sonradan kesim yok.

## Basma adımları ve kapalı kılıf (kesit)

## Kapalı kılıf

## Kullanım

1. Levhayı ısıt, çerçevesi aşağı bakacak şekilde dişi kalıbın cebine koy; çerçeve oluğa oturur.
2. Erkek kalıbı ters çevirip üstten bastır; taban plakası dişinin üstüne değene kadar.
3. Soğuyunca çıkar. İkinci levhayla tekrarla.
4. Cihazı koy, iki kabuğu kapat, yanlara kıskaçları tak, üstteki vidaya somunu çevir.

## Denetimler

Healy (56×58×18,5, alttaki V çentiğiyle) kapalı kılıfa sığıyor | dışarıda kalan 0 mm³
Düz levha cepte, dişi kalıpla çakışma | 0
Levha 0,3 mm sağa/yukarı kayarsa | çakışıyor (19 / 15 mm³) → kayamaz, kilitli
Şekillenmiş kabuk dişi kalıpta | çakışma 0
Erkek kalıp sonuna kadar indi: kabukla / dişiyle | 0 / 0
İki kabuk kapalı | çakışma 0
Kıskaçlar kapalı kabuklarda | çakışma 0
Tüm parçalar su geçirmez | evet
PLA 3MF denetimi | 0 hata

Varsayım: Healy'nin altında 37 mm eninde, 11 mm derinliğinde bir V çentiği var ve kılıf bu çentiği izliyor. Cihazın kenarları yuvarlak değil, düz kutu kabul edildi.
