besturk/claude-todo/makerworld-thermoform/healy-kalip/formify-karsilastirma.html

# Formify kiti ve benim v4 kalıbım

Formify kiti useless.works/thermoform sayfasında oluşturuldu: dikdörtgen, 58×60 mm, köşe 7 mm, şekil derinliği 10 mm, levha 0,6 mm, diğer ayarlar varsayılan. Tüm ölçüler indirilen dosyadan ölçüldü.

## 1. Parçalar

Formify

Benim v4

## 2. Farklar

| Formify | Benim v4
Kalıp mantığı | Kalıp, şekillenmiş levha yüzeyinden türetiliyor: dişi = yüzey +0,1 mm, erkek = yüzey −0,1 mm. İkisi birbirinin tam negatifi. | Dişi kap + ayrı zıpka; aralarında levha kalınlığı kadar (1,6 mm) boşluk.
Levha sabitleme | Dişi kalıpta levhanın çerçevesine birebir oturma cebi + kılavuz duvar var; erkek kalıp bu duvarın içine kılavuzlu iniyor → levha kayamıyor. | Kılavuz yok; levha kalıbın üstüne düz konuyor, zıpka bastırınca kayıyor (yaşadığın 'yamulma').
Şekil | Kubbe (yastık): ortada 10 mm, kenara doğru 0'a iniyor. | Kutu: tabandan düz 9,4 mm duvar + 0,6 mm hafif kubbe.
Levha kalınlığı | 0,6 mm (ayar aralığı 0,4–1,6) | 1,6 mm
Levha çerçevesi | 1,2 mm genişlik, 2 mm yükseltilmiş kenar (rim) | 4,6 mm düz çerçeve + kulaklar
Görünürlük deseni | Modellenmiş altıgen kafes: aralık 4 mm, çubuk 0,8 mm → içi görünür | Desen yok / dilimleyicide honeycomb dolgu
Üst birleşim | Boyunda yarım vida (Ø10, adım 2, boy 6) + askı halkalı somun | Yarım vidalar (Ø7, iki ağızlı) + askı halkalı somun — aynı fikir
Yan/alt kapama | Vida varsa sadece altta TEK kıskaç (6×6,6×3 mm) | Yanlarda 2 C kıskaç + levhada kulak/yuva
Kalıp sayısı | Ön ve arka için ayrı dişi/erkek (bu kitte 1 çift) | 1 dişi + 1 zıpka, iki levha aynı kalıpta
Malzeme / yazıcı | Kalıp PETG, levha PLA; A1 mini profili | Kalıp PETG, levha PLA; P2S profili
Healy (56×58×18,5) sığar mı? | HAYIR. 58×60 levha dış ölçüsü sayılıyor; kubbe sadece ortada 10 mm. 9,25 mm'lik Healy yarısının %54'ü kalıbın dışında kalıyor (ölçüldü). | EVET. Kenarda 18,8 / ortada 20 mm iç hacim; 18,5 mm cihaz dışarı taşmıyor (ölçüldü).

## 3. Kesit — Healy yarısı kalıba sığıyor mu?

Kırmızı kesikli kutu: Healy'nin bir kabuğa düşen yarısı (9,25 mm).

## 4. Kalıp derinliği boydan boya

Formify'ın kubbesi yalnızca ortadaki ~20 mm'lik bölgede 9,25 mm'yi geçiyor; kenarlarda cihaz sığmıyor.

## Sonuç

Formify'ın levhayı sabitleme yöntemi (çerçeve cebi + kılavuzlu erkek kalıp), ince levha, dar yükseltilmiş çerçeve, modellenmiş kafes deseni ve tek alt kıskaç benimkinden iyi. Ama kubbe şekli kutu biçimli Healy'yi almıyor. En sağlam yol: Formify'ın yapısını alıp şekli Healy'ye göre kutu yapmak.
