besturk/claude-todo/makerworld-thermoform/healy-kalip/levha-karsilastirma.html

# Verdiğim levha ↔ önerdiğim levha

Ölçüler dosyalardan ölçüldü (OpenSCAD + trimesh). Mavi = verdiğim, yeşil = önerdiğim.

| Verdiğim (ölçülen) | Önerdiğim (ölçülen) | Söylediğim | Not
Levha kalınlığı | 4,0 mm | 2,4 mm | 2,4 mm | —
Levha dış ölçü | 74 × 86 mm | 74 × 85 mm | — | kulak küçüldüğü için 1 mm kısa
İki kenar üst üste | 8,0 mm | 4,8 mm | 4,8 mm | —
C kıskaç ağzı | 8,2 mm | 5,0 mm | 5,0 mm | —
Vida çapı / adım | 8 mm / 2,5 | 6 mm / 1,5 | 6 mm | —
Vida boyu (gözüyle) | 32,2 mm | 21,2 mm | ≈16 mm | SÖZÜM TUTMADI: 16 dedim, ölçü 21,2
Göz dış / ip deliği | 15 / 7 mm | 10 / 4,5 mm | 10 / 4,5 mm | —
Somun | 14,8 mm, 5 mm kalın | 11,1 mm, 3 mm kalın | 3 mm kalın | —
Vida-somun dişi | çakışmasız | çakışmasız | — | ikisi de ölçüldü
Kalıp pimi | 3,6 mm (basılan) | levhadan 1,2 mm taşar | kırpılmalı | basılan kalıpta ~1,2 mm kırp

Levhalar, aynı ölçekte üstten.

Vida, somun, C kıskaç — aynı ölçekte.
