besturk/claude-todo/makerworld-thermoform/healy-cerceve/sekil-secenekleri.html

# Desen neden bozuluyor, ne yapılabilir

## 1. Kalıbın şeklini yumuşatmak

Şekil | Toplam esneme (yüzey / açıklık) | Kesit boyunca esneme | Healy (18,5) sığıyor mu | Kalıp
Mevcut şekil (basılan) | 1.56 | 1.28 | sığıyor (0 mm³) | değişmez
Yuvarlak omuz (r5, 4°) | 1.55 | 1.25 | ancak kılıf her yönde ~1 mm büyürse (3,8 mm³, sınırda) | erkek kalıp + çerçeve değişir
Geniş omuz (r8, 8°) | 1.53 | 1.22 | sığmıyor (1454 mm³ dışarıda) | —
Kalp gibi kubbe | 1.54 | 1.23 | sığmıyor (2887 mm³ dışarıda) | —
Referans: çalışan kalp | 1.54 | 1.19 | — | —

Toplam esneme kalp kalıbıyla neredeyse aynı (1,56 ve 1,54). Fark, esnemenin nerede toplandığında: kalpte kubbeye yayılıyor, Healy'de ön yüz neredeyse hiç esnemiyor, bütün uzama 10 mm'lik yan duvarda ve köşelerde oluyor. Healy kutu biçimli olduğu için şekli kubbeye çeviremeyiz; yumuşak omuz da esnemeyi ancak çok az azaltıyor (1,27 → 1,25) ve kılıfı büyütüyor.

## 2. Kalıbı değiştirmeden deseni bölmek

Sağdaki harita: levhanın mavi kısmı kalıbın düz ön yüzüne gelir ve az esner; kırmızı halka yan duvarı ve köşeleri oluşturur, bütün uzama burada olur; gri kısım çerçevenin altında düz kalır. Ortadaki alternatifte petek yalnızca mavi kısımda kalır, kırmızı halka dilimleyicide dolu (eş merkezli %100) basılır. Kalp levhasındaki kenar bandının aynısı, sadece içeri doğru genişletilmiş hali.

Önerim: 2. yol. Kalıplar değişmiyor; vida düzeltmesiyle birlikte PETG'yi şimdi bir kere basarsın. Ön yüzdeki petekler düzgün kalır, yan duvarlar düz ve pürüzsüz olur. Denenmemiş kısım: dolu duvar bandının 10 mm'lik duvara düzgün gerilip gerilmeyeceği.
