besturk/claude-todo/makerworld-thermoform/vust.png

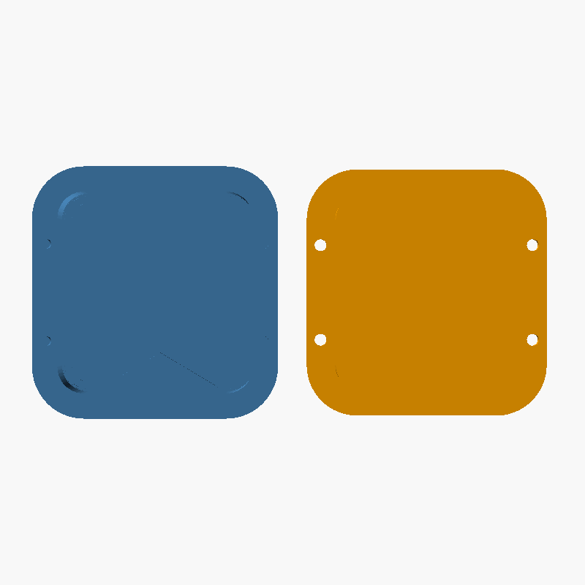
makerworld-thermoform/vust.png
