besturk/claude-todo/(commit log)

2026-10-11 MakerWorld Parametric Model Maker için thermoform takımı (OpenSCAD)
    Ağsı levha, dişi kalıp, erkek zıpka, asma kapağı, klipsler ve isteğe
    bağlı göz/ağız oyukları; 10 hazır silüet, Customizer parametreleriyle.
    Claude-Session: https://claude.ai/code/session_015y3Ujohe5FiucFBiFiWe5V
    [thermoform.scad]
2026-10-11 Levhayı kalıp pimleriyle sabitle, kabukları geçme pimle birleştir
    Levha kenarına iki yana simetrik delikler açılır; kalıp flanşındaki pimler
    şekil verirken levhayı tutar, aynı delikler sonra tutamaklı geçme pimlerle
    iki kabuğu birleştirir. U klipsler kaldırıldı, asma kapağı kaldı. Çiçek
    silüeti dikey eksene göre simetrik hale getirildi.
    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
    [thermoform.scad]
2026-10-11 Kullanılmayan sira modülünü kaldır
    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
    [thermoform.scad]
2026-10-11 50 mm kare için kalıp ve zıpka STL'leri
    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
    [kare50-kalip.stl, kare50-zipka.stl]
2026-10-11 Ölçüleri mm ile girilen kutu şekli ve Healy boyutunda kalıp
    İç ölçü 58 x 60 mm, köşe 7 mm; kabuk başına düz derinlik 9 mm, kubbe 4 mm.
    56 x 58 mm cihaz kapalı kılıfa 22 mm kalınlığa kadar sığıyor (ölçüldü).
    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
    [healy-kalip.stl, healy-zipka.stl, thermoform.scad]
2026-10-11 Healy kılıfı: alt V açıklığı, yan C kıskaçlar, üstte gözlü vida
    Levhadan kablo için V kesilir; C kıskaçların tırnakları kenar deliklerine
    oturur; üst kulaktan geçen baskı vida + somun iki kabuğu birleştirir ve
    askı vidanın gözünden geçer. Vida-somun dişi tüm boyda çakışmasız (ölçüldü).
    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
    [healy-kilif.scad, healy-kiskac-vida-somun.stl, healy-levha.stl]
2026-10-11 Healy kalıp + zıpka tek tablalık PETG 3MF (P2S)
    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
    [healy-kalip-PETG.3mf]
2026-10-11 Healy levhalar + kıskaç/vida/somun tek tablalık PLA 3MF (P2S)
    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
    [healy-levhalar-PLA.3mf]
2026-10-11 Vida/göz/somun ölçüleri ayarlanabilir; levha karşılaştırma sayfası
    C kıskaç ağzı levha kalınlığından hesaplanıyor. Varsayılanlar önceki
    geometriyi veriyor.
    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
    [healy-kilif.scad]
2026-10-11 Healy kılıfı: levhada yarım vida, askılı somun; levha 2,4 mm
    Her levhanın üst kenarında iki ağızlı dişli yarım vida var; aynı levha ters
    çevrilip kapanınca iki yarım tam vida oluyor (hacim farkı 0,8 mm3, kesim
    yüzeyi). Askılı somun iki yarıyı bağlıyor, halkanın deliği sağ-sol yönünde.
    Ayrı gözlü vida ve kulak kaldırıldı.
    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
    [healy-kilif.scad, healy-kiskac-somun.stl, healy-kiskac-vida-somun.stl, healy-levha.stl, healy-levhalar-PLA.3mf]
2026-10-11 Healy PETG kalıp + zıpka 2,4 mm levhaya göre yeniden üretildi (pim 2 mm)
    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
    [healy-kalip-PETG.3mf, healy-kalip.stl, healy-zipka.stl]
2026-10-12 Healy kalıbı v2: iç 18,8/20 mm, V kesim çizgisi sırtı, zıpkada pim delikleri
    Levha V kesilmeden bütün bastırılıyor; kalıp boşluğundaki 0,8 mm sırt V
    çizgisini kabuğa kabartıyor. Zıpka flanşındaki delikler pimlerin zıpkayı
    durdurmasını önlüyor. 18,5 mm cihaz kapalı kabuklara sığıyor (ölçüldü).
    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
    [TF-Healy-kalip-PETG.3mf, healy-kalip-PETG.3mf, healy-kalip.stl, healy-kilif.scad, healy-levha.stl, healy-zipka.stl]
2026-10-12 Healy levhası: V önceden kesilir, kenar kalıptaki sırta dayanır
    Sırt kesim çizgisi değil dayanak; sonradan kesim yok. Levha kenarı ile sırt
    arası plan görünüşte 0,15 mm (ölçüldü).
    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
    [healy-kilif.scad, healy-levha.stl]
2026-10-12 Healy levhası: modelde açılan bal peteği deseni (petek_d, petek_cubuk)
    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
    [healy-kilif.scad]
2026-10-12 Healy v3: 5 desen, her yanda tek dörtgen yuvalı ince C kıskaç, dörtgen pim
    Desenler modelde açılıyor (bal peteği, baklava, kare, daire, üçgen); levha
    normal ayarla basılır. Kıskaç tırnakları dörtgen yuvaya oturuyor (çakışma 0,
    ölçüldü). Kalıp pimi ve zıpka deliği dörtgen. Somun ve kıskaçlara brim.
    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
    [TF-Healy-kalip-PETG.3mf, TF-Healy-levhalar-PLA.3mf, healy-kalip.stl, healy-kilif.scad, healy-levha.stl, healy-zipka.stl]
2026-10-12 Healy v4: referans fotoğraftaki yapı — fincan kalıp, taban plakalı zıpka, ince kenarlı levha
    Kalıp duvarı 3 mm, üst kenar dar, pim yok; levhanın dış hattı = kalıbın dış
    hattı. Zıpka taban plakası levha kenarını kalıp kenarına sıkıştırır. Levha
    1,6 mm, kabuksuz honeycomb %20, 5 duvarlık kenar şeridi; yanlarda kulak,
    kıskaç yuvası kulakta. Yan boşluk = levha kalınlığı. Ölçümler: 18,5 mm cihaz
    sığıyor, levha/zıpka/kıskaç çakışma 0.
    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
    [TF-Healy-kalip-PETG.3mf, TF-Healy-levhalar-PLA.3mf, healy-kalip.stl, healy-kilif.scad, healy-levha.stl, healy-zipka.stl]
2026-10-12 Healy: Formify yapısıyla kalıp, levha, kıskaç ve somun
    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
    [TF-Healy-F-kalip-PETG.3mf, TF-Healy-F-levhalar-PLA.3mf, healy-f-disi.stl, healy-f-erkek.stl, healy-f-kiskac.stl, healy-f-levha.stl, healy-f-somun.stl, healy-formify.scad]
2026-10-12 Healy Formify: yarım vida kalıpta baştan sona yataklandı ve bastırılıyor
    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
    [TF-Healy-F-kalip-PETG.3mf, TF-Healy-F-levhalar-PLA.3mf, healy-f-disi.stl, healy-f-erkek.stl, healy-f-levha.stl, healy-formify.scad]
2026-10-12 Healy Formify: levha kalınlığı 1,0 mm, kalıplar buna göre
    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
    [TF-Healy-F-kalip-PETG.3mf, TF-Healy-F-levhalar-PLA.3mf, healy-f-disi.stl, healy-f-erkek.stl, healy-f-levha.stl, healy-formify.scad]
2026-10-12 Healy: çerçeve yöntemiyle erkek kalıp, oluklu çerçeve, kaburgalı levha
    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
    [healy-c-bant.stl, healy-c-cerceve_baski.stl, healy-c-erkek.stl, healy-c-kiskac.stl, healy-c-levha.stl, healy-c-somun.stl, healy-cerceve.scad]
2026-10-12 Healy çerçeve: V levhada önceden açık, kenarını çerçeve bastırıyor
    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
    [healy-c-bant.stl, healy-c-cerceve_baski.stl, healy-c-erkek.stl, healy-c-levha.stl, healy-cerceve.scad]
2026-10-12 Healy çerçeve: çok parçalı 3MF yazıcı, PETG kalıp seti ve PLA levha seti
    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
    [TF-Healy-cerceve-kalip-PETG.3mf, TF-Healy-cerceve-levha-PLA.3mf, healy-c-direk_destek.stl, healy-c-kaburga.stl, healy-c-levha_duz.stl, healy-c-vida.stl, healy-cerceve.scad]
2026-10-13 Healy çerçeve: V için 'üst yüzde biten levha + çerçeve dudağı' seçeneği ve karşılaştırma
    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
    [healy-cerceve.scad]
2026-10-13 Healy çerçeve: V açık (levha üst yüzde biter, çerçeve dudağı), çerçeve 12 mm düz üst, 3MF'ler güncel
    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
    [TF-Healy-cerceve-kalip-PETG.3mf, TF-Healy-cerceve-levha-PLA.3mf, healy-c-bant.stl, healy-c-cerceve_baski.stl, healy-c-direk_destek.stl, healy-c-erkek.stl, healy-c-kaburga.stl, healy-c-levha.stl]
2026-10-13 Healy çerçeve: şekil/desen seçenekleri karşılaştırması, d_pay parametresi
    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
    [healy-cerceve.scad]
2026-10-14 Healy: Hello Kitty yöntemiyle dişi + erkek kalıp, 0,8 mm kaburgalı levha (yöntem denemesi)
    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
    [TF-Healy-HK-kalip-PETG.3mf, TF-Healy-HK-levha-PLA.3mf, healy-hk-disi.stl, healy-hk-erkek.stl, healy-hk-levha.stl, healy-hk.scad]
2026-10-14 Healy HK yöntemi: V açıklığı, 9 mm pahlı yarım vida + somun, kıskaç; tam set 3MF
    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
    [TF-Healy-HK-kalip-PETG.3mf, TF-Healy-HK-levha-PLA.3mf, healy-hk-disi.stl, healy-hk-erkek.stl, healy-hk-kiskac.stl, healy-hk-levha.stl, healy-hk-levha_govde.stl, healy-hk-somun.stl]
2026-10-16 Healy HK: kıskaç yuvası taslak modeli ve kalp-80 analiz betiği (arşiv için)
    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
    [kiskac-yuvasi-taslak.scad]
